johncohn/TalkingCOVIDMask/images/mask smile.png

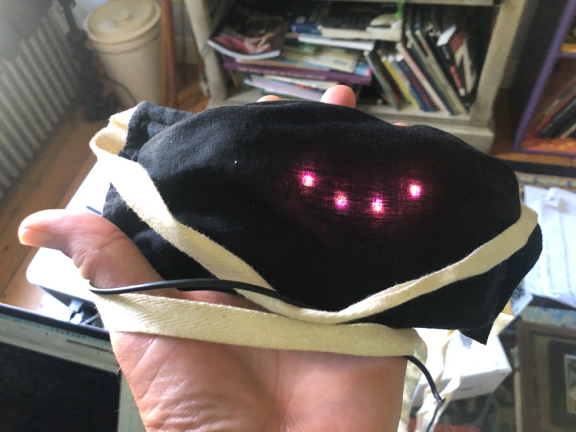
images/mask smile.png
